shreenandansonu/alphion_potentiostat/readme.md

# ALPHION POTENTIOSTAT
<p align ="center">
    <a href="https://alphaion.io/">
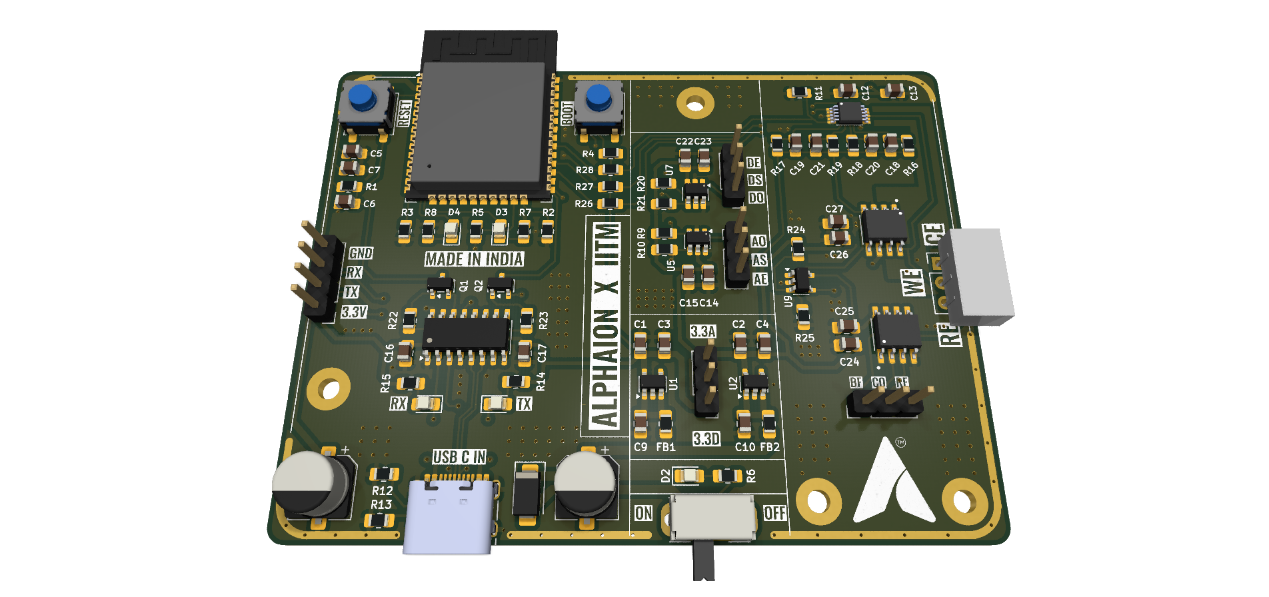
[picture p1: IMAGES/Potentiostat.png]
        
    </a>
</p>

## Overview

This Project is a basemodel for the ALPHION POTENTIOSTAT. Which is based on the research done at IITM by Bikash Kumar Mishra
