shreenandansonu/alphion_potentiostat/PCB DESIGN/Components/LMP7721MAX_NOPB/LMP7721MAX_NOPB.STEP

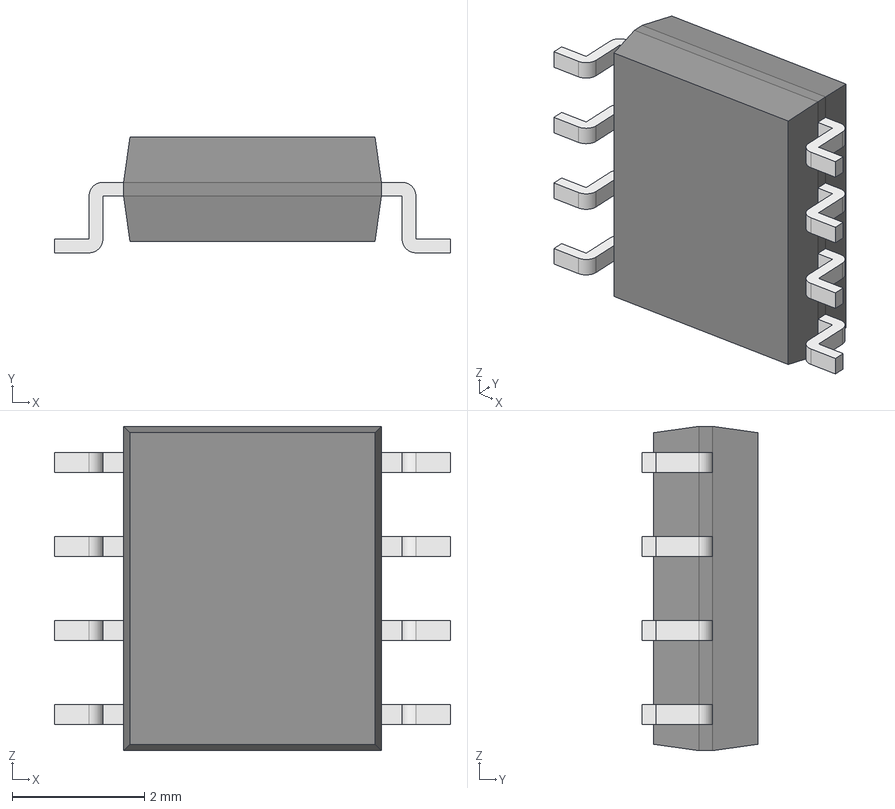
[picture p15: CAD file, 2026-10-17]
PCB DESIGN/Components/LMP7721MAX_NOPB/LMP7721MAX_NOPB.STEP
5.99 x 1.75 x 4.91 mm
Body001 (Mirror #1) x 4
XY-plane x 12
X-axis x 12
