shreenandansonu/alphion_potentiostat/PCB DESIGN/Components/OPA2320AIDGKR/OPA2320AIDGKR.step

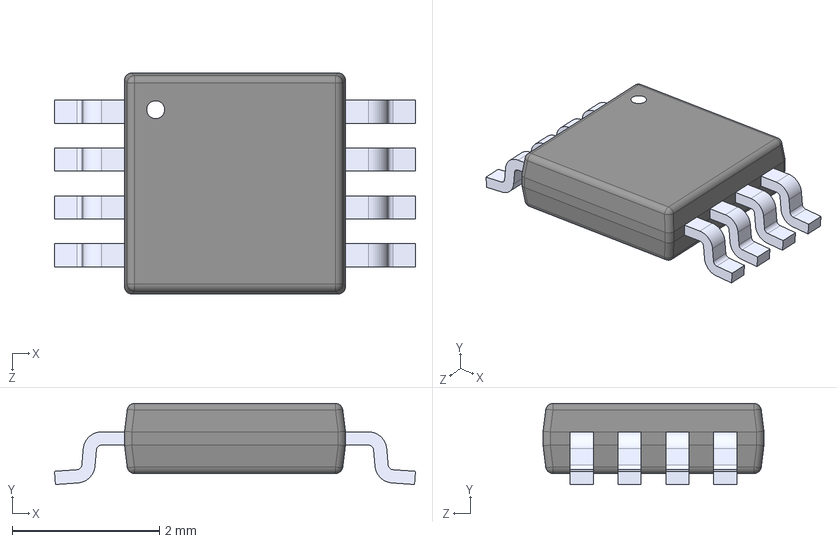
[picture p16: CAD file, 2026-10-17]
PCB DESIGN/Components/OPA2320AIDGKR/OPA2320AIDGKR.step
4.90 x 1.10 x 3.00 mm
