shreenandansonu/alphion_potentiostat/PCB DESIGN/Potentiostat/Electrode.stp

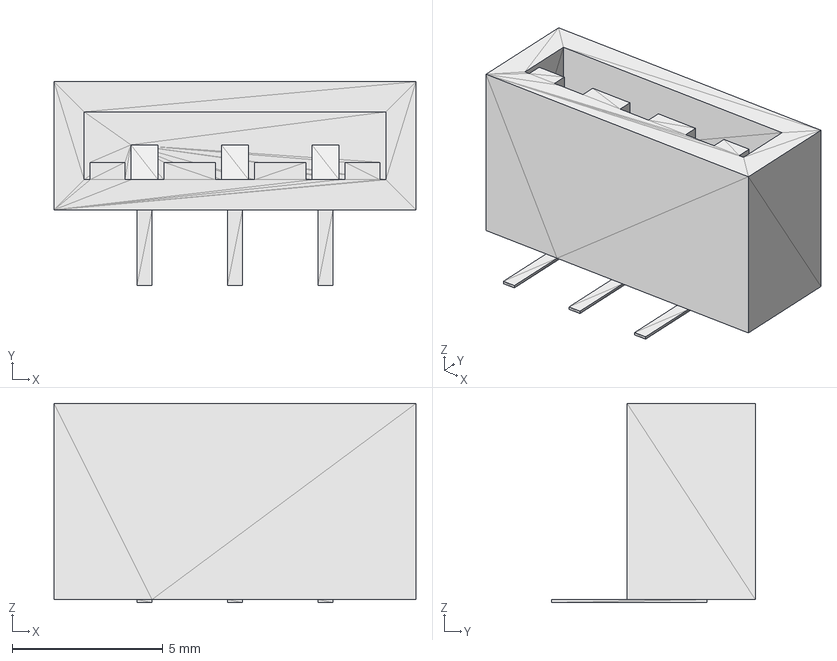
[picture p17: CAD file, 2026-10-17]
PCB DESIGN/Potentiostat/Electrode.stp
12.0 x 6.75 x 6.60 mm
