shreenandansonu/alphion_potentiostat/PCB DESIGN/Potentiostat/TYPE-C-31-M-12--3DModel-STEP-56544.STEP

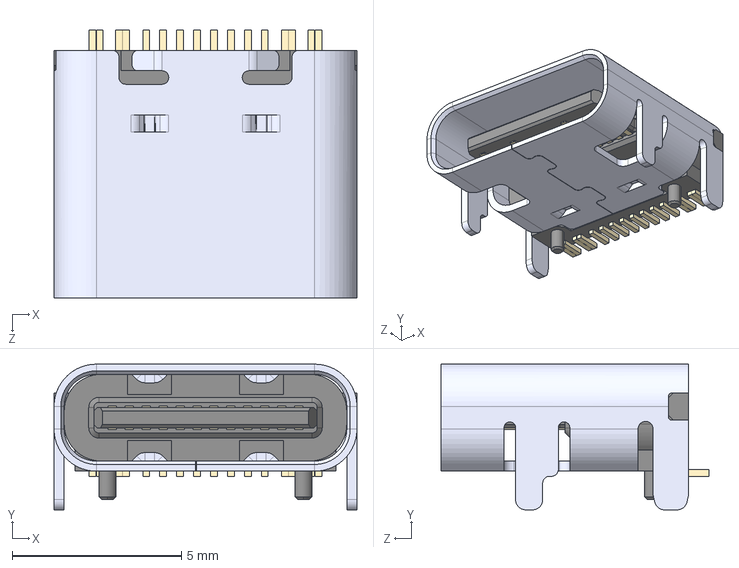
[picture p18: CAD file, 2026-10-17]
PCB DESIGN/Potentiostat/TYPE-C-31-M-12--3DModel-STEP-56544.STEP
8.94 x 4.30 x 7.90 mm
