shreenandansonu/alphion_potentiostat/CODES/MCP4725_TEST/Test Result.png

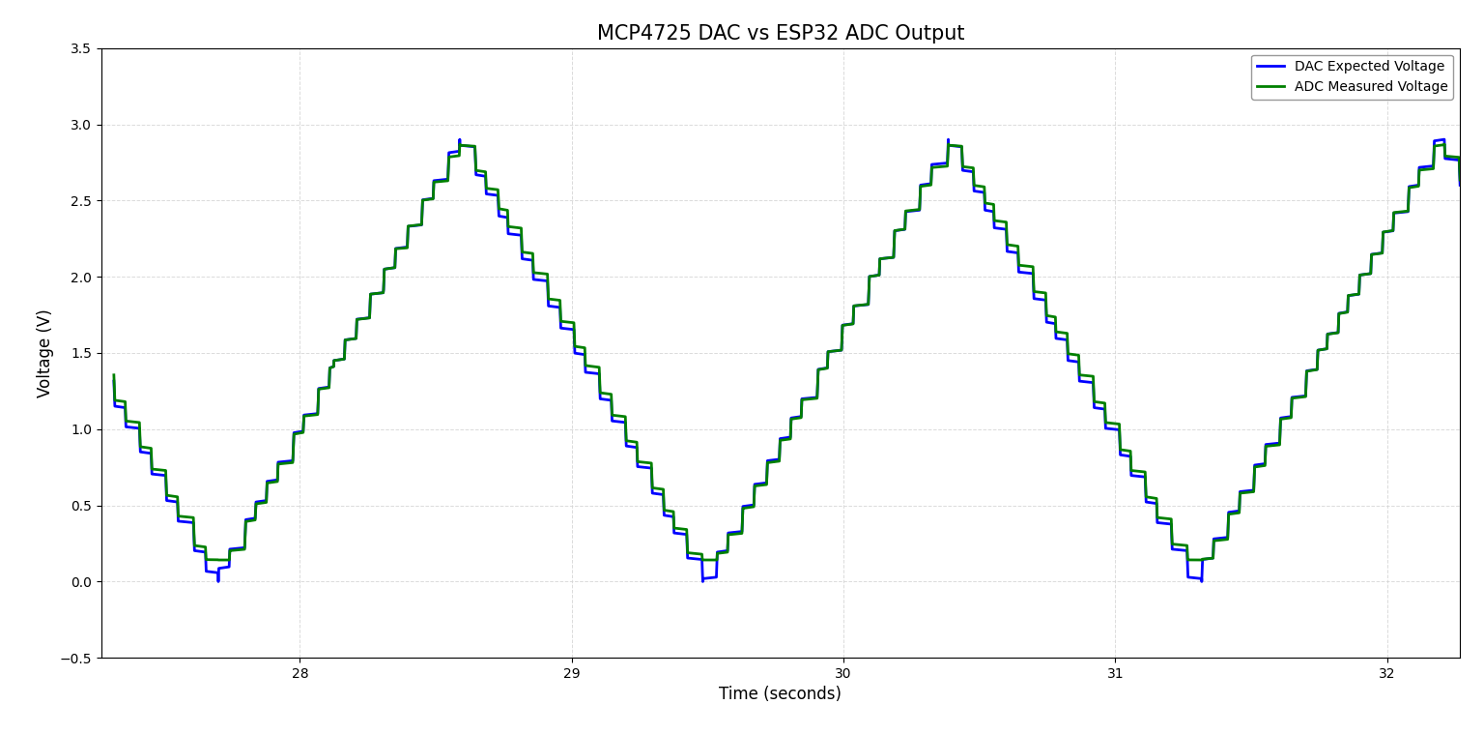
CODES/MCP4725_TEST/Test Result.png
