shreenandansonu/alphion_potentiostat/PCB DESIGN/Potentiostat/Potentiostat.pdf

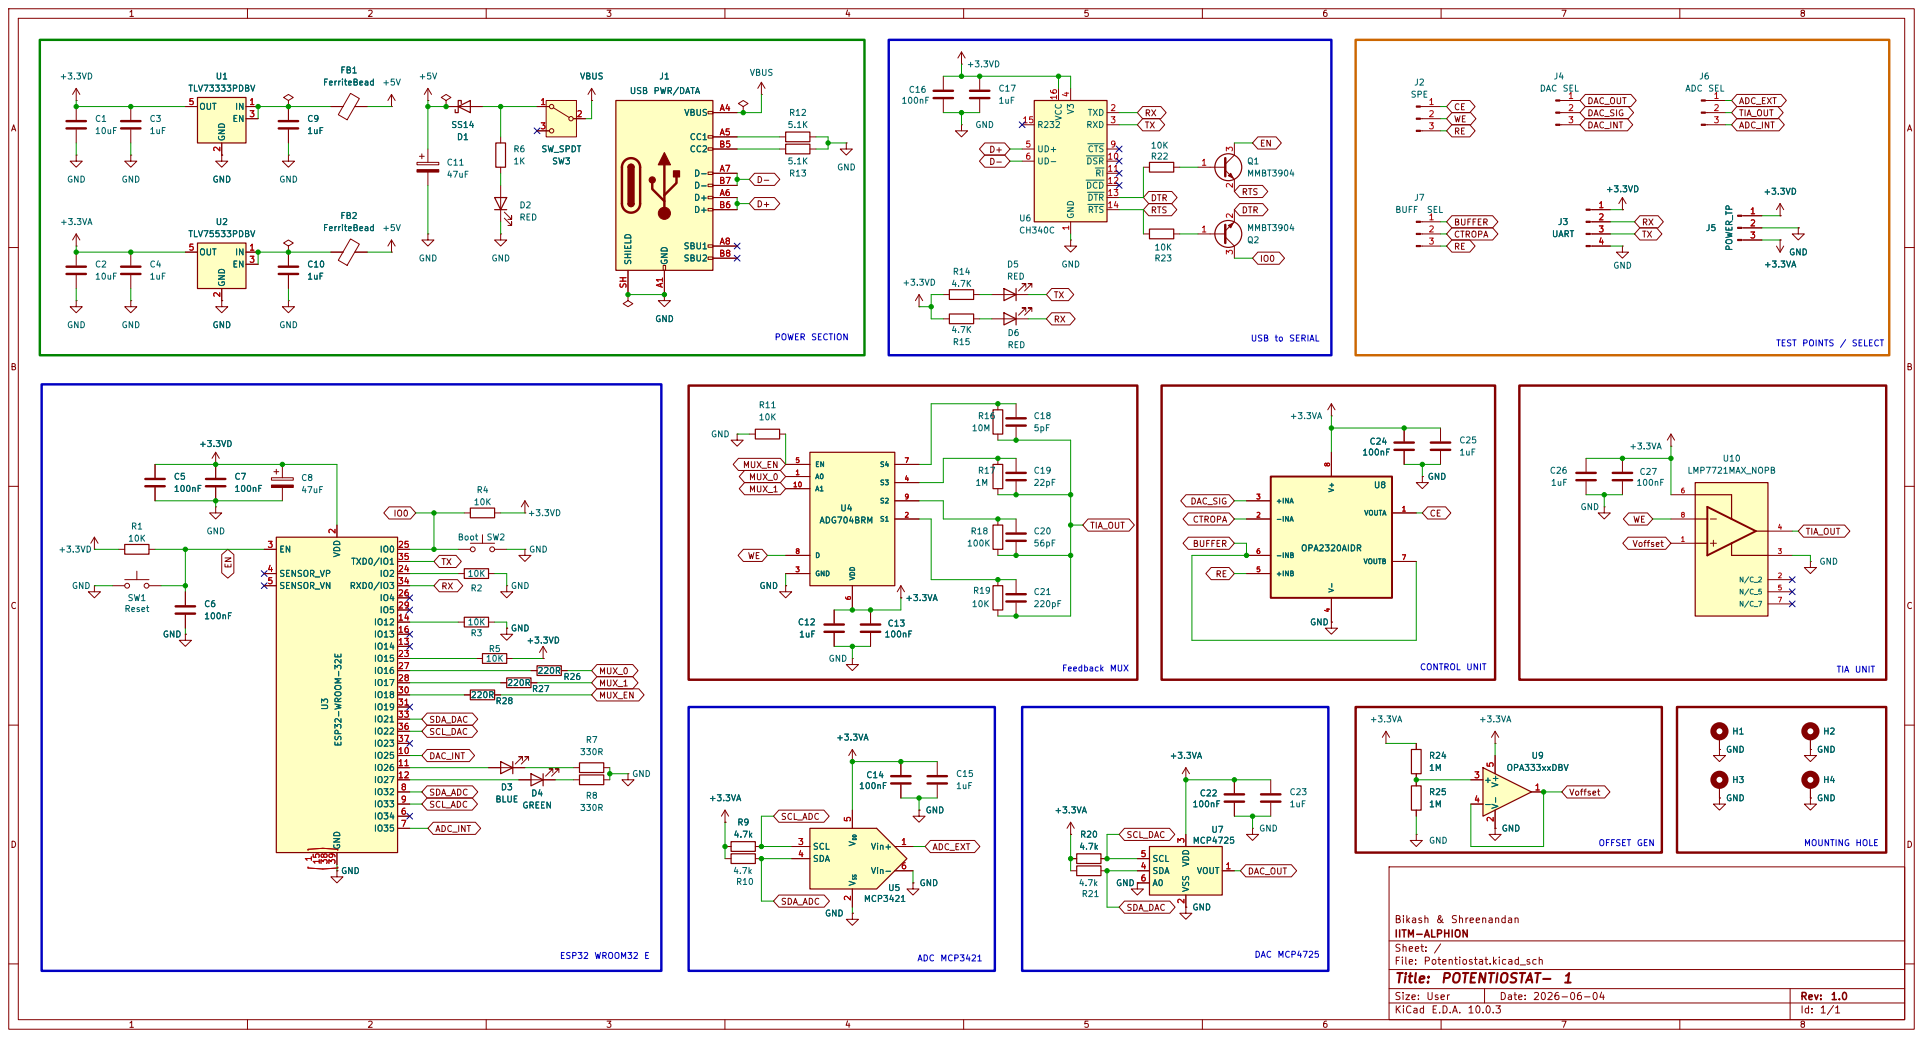
[picture p20: page 1]

VBUS GND A1
J1 USB PWR/DATA GND A1

4 UD+ 5 UD- 6 CTS 9 DSR 10 RI 11 DCD 12 DTR 13 RTS 14 R232 15 VCC 16 U6CH340C

Size: User | Rev: 1.0
KiCad E.D.A. 10.0.3 | Id: 1/1
