shreenandansonu/alphion_potentiostat/PCB DESIGN/Potentiostat/Potentiostat.kicad_pcb

## KiCad design PCB DESIGN/Potentiostat/Potentiostat.kicad_pcb (2026-10-17)

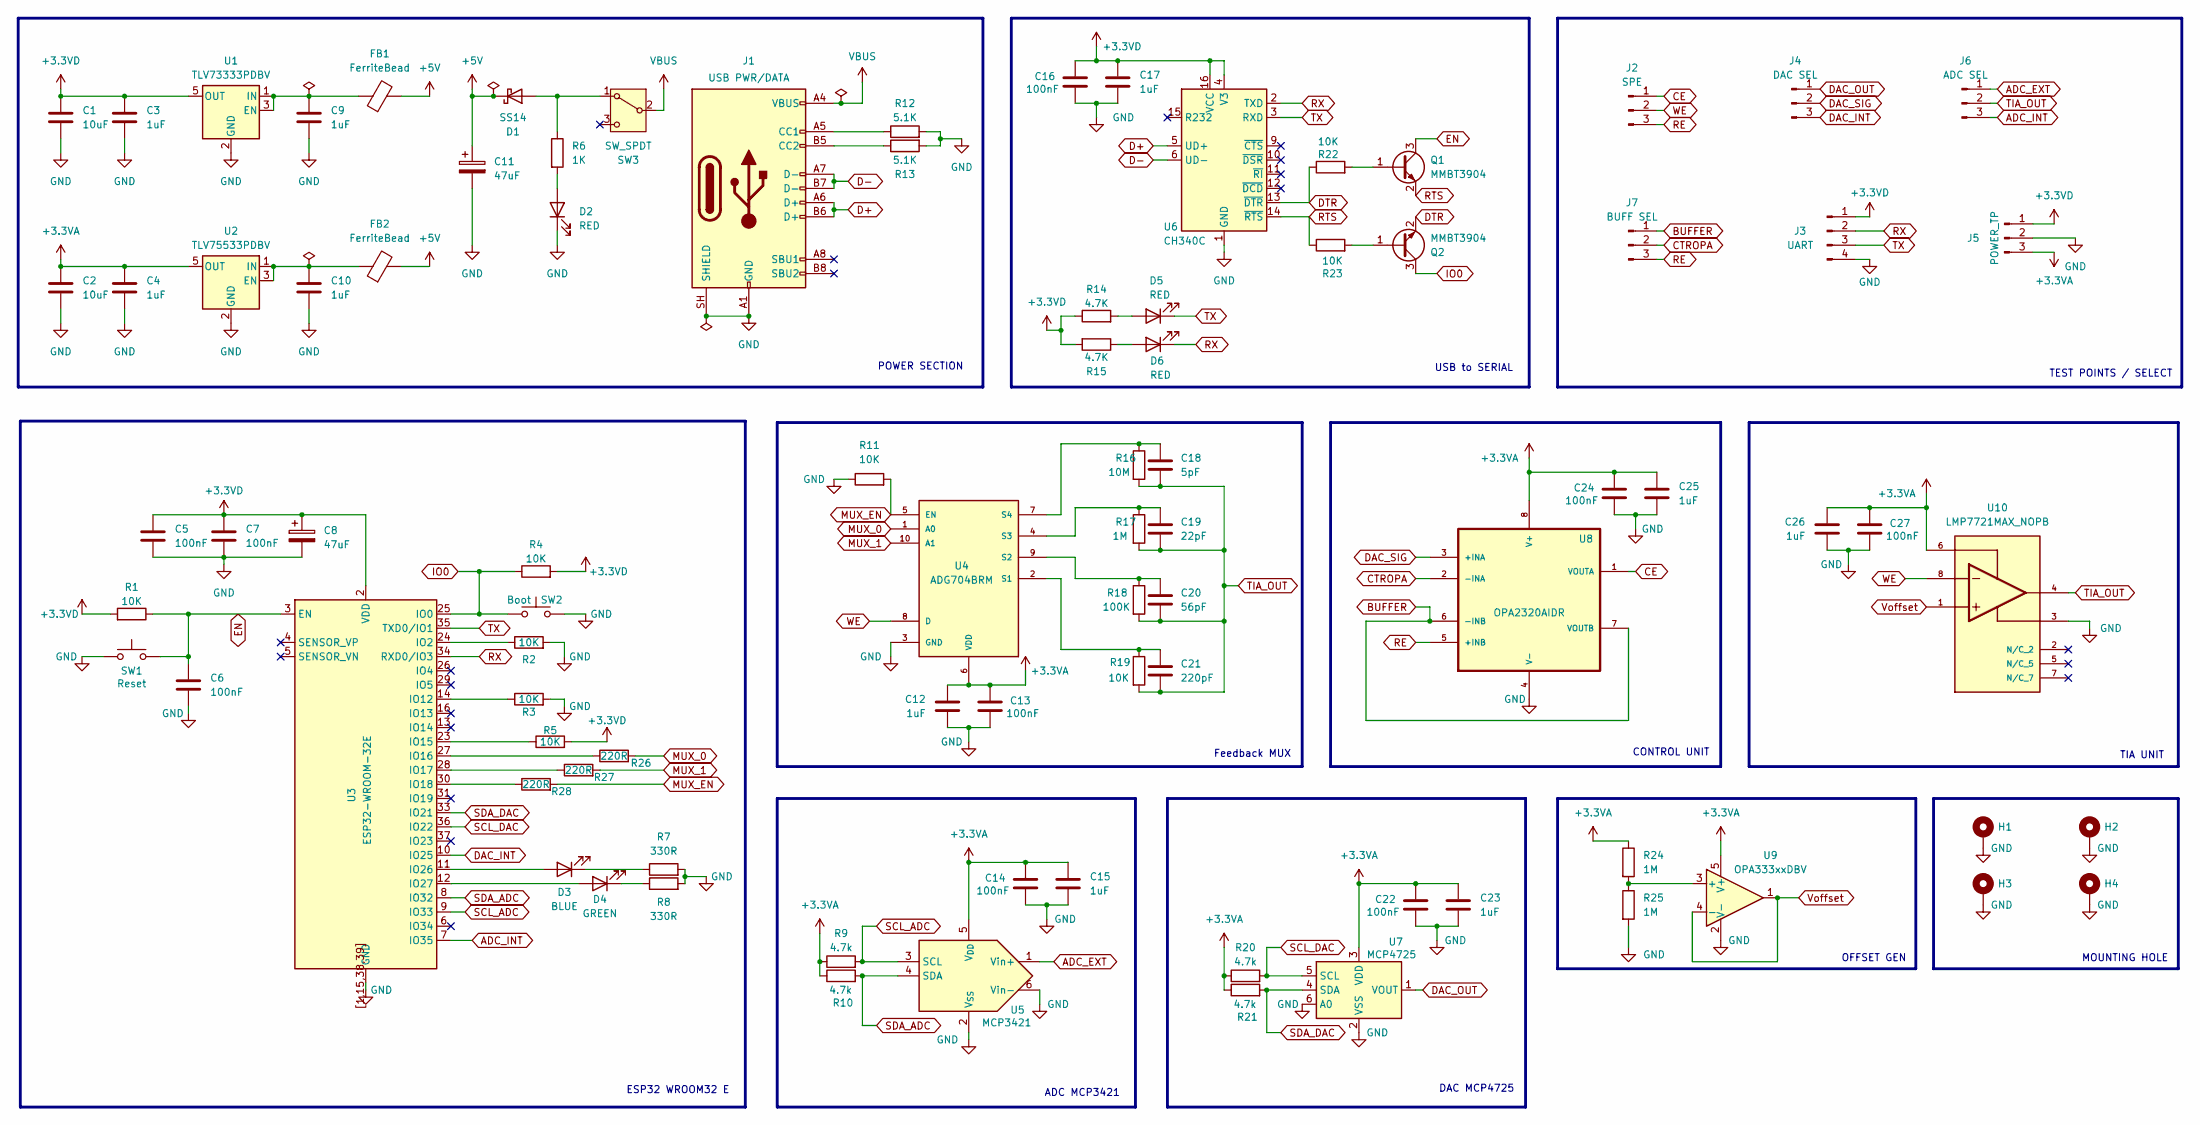
[picture p21: schematic Potentiostat.kicad_sch, POTENTIOSTAT- 1]

Parts:
C1, C2: 10uF; C_0805_2012Metric_Pad1.18x1.45mm_HandSolder
C3, C4, C9, C10, C12, C15, C17, C23, C25, C26: 1uF; C_0805_2012Metric_Pad1.18x1.45mm_HandSolder
C5, C6, C7, C13, C14, C16, C22, C24, C27: 100nF; C_0805_2012Metric_Pad1.18x1.45mm_HandSolder
C8, C11: 47uF; CP_Elec_6.3x5.8
C18: 5pF; C_0805_2012Metric_Pad1.18x1.45mm_HandSolder
C19: 22pF; C_0805_2012Metric_Pad1.18x1.45mm_HandSolder
C20: 56pF; C_0805_2012Metric_Pad1.18x1.45mm_HandSolder
C21: 220pF; C_0805_2012Metric_Pad1.18x1.45mm_HandSolder
D1: SS14; D_SMA
D2, D5, D6: RED; LED_0805_2012Metric_Pad1.15x1.40mm_HandSolder
D3: BLUE; LED_0805_2012Metric_Pad1.15x1.40mm_HandSolder
D4: GREEN; LED_0805_2012Metric_Pad1.15x1.40mm_HandSolder
FB1, FB2: FerriteBead; R_0805_2012Metric_Pad1.20x1.40mm_HandSolder
H1, H2, H3, H4: MountingHole_2.5mm_Pad
J1: USB PWR/DATA; USB_C_Receptacle_HRO_TYPE-C-31-M-12
J2: SPE; PinHeader_1x03_P2.54mm_Vertical
J3: UART; PinHeader_1x04_P2.54mm_Vertical
J4: DAC SEL; PinHeader_1x03_P2.54mm_Vertical
J5: POWER_TP; PinHeader_1x03_P2.54mm_Vertical
J6: ADC SEL; PinHeader_1x03_P2.54mm_Vertical
J7: BUFF SEL; PinHeader_1x03_P2.54mm_Vertical
Q1, Q2: MMBT3904; SOT-23
R1, R2, R3, R4, R5, R11, R19, R22, R23: 10K; R_0805_2012Metric_Pad1.20x1.40mm_HandSolder
R6: 1K; R_0805_2012Metric_Pad1.20x1.40mm_HandSolder
R7, R8: 330R; R_0805_2012Metric_Pad1.20x1.40mm_HandSolder
R9, R10, R20, R21: 4.7k; R_0805_2012Metric_Pad1.20x1.40mm_HandSolder
R12, R13: 5.1K; R_0805_2012Metric_Pad1.20x1.40mm_HandSolder
R14, R15: 4.7K; R_0805_2012Metric_Pad1.20x1.40mm_HandSolder
R16: 10M; R_0805_2012Metric_Pad1.20x1.40mm_HandSolder
R17, R24, R25: 1M; R_0805_2012Metric_Pad1.20x1.40mm_HandSolder
R18: 100K; R_0805_2012Metric_Pad1.20x1.40mm_HandSolder
R26, R27, R28: 220R; R_0805_2012Metric_Pad1.20x1.40mm_HandSolder
SW1: Reset; SW_Push_1P1T_NO_CK_KSC7xxJ
SW2: Boot; SW_Push_1P1T_NO_CK_KSC7xxJ
SW3: SW_SPDT; SW_Slide_SPDT_Angled_CK_OS102011MA1Q
U1: TLV73333PDBV; SOT-23-5
U2: TLV75533PDBV; SOT-23-5
U3: ESP32-WROOM-32E
U4: ADG704BRM; MSOP10
U5: MCP3421; SOT-23-6
U6: CH340C; SOIC-16_3.9x9.9mm_P1.27mm
U7: MCP4725; SOT-23-6_Handsoldering
U8: OPA2320AIDR; SOIC127P599X175-8N
U9: OPA333xxDBV; SOT-23-5
U10: LMP7721MAX_NOPB; SOIC127P599X175-8N; PARTREV E

Connections:
+3.3VA: C2.1, C4.1, C12.1, C13.1, C14.1, C15.1, C22.1, C23.1, C24.1, C25.1, C26.1, C27.1, J5.3, R9.1, R10.1, R20.1, R21.1, R24.1, U2.5 (OUT), U4.6 (VDD), U5.5 (V_{DD}), U7.3 (VDD), U8.8 (V+), U9.5 (V+), U10.6
+3.3VD: C1.1, C3.1, C5.1, C7.1, C8.1, C16.1, C17.1, J3.1, J5.1, R1.2, R4.2, R5.2, R14.1, R15.2, U1.5 (OUT), U3.2 (VDD), U6.4 (V3), U6.16 (VCC)
+5V: C11.1, D1.1 (K), FB1.2, FB2.2
ADC_EXT: J6.1, U5.1 (Vin+)
ADC_INT: J6.3, U3.7 (IO35)
BUFFER: J7.1, U8.6 (-INB), U8.7 (VOUTB)
CE: J2.1, U8.1 (VOUTA)
CTROPA: J7.2, U8.2 (-INA)
D+: J1.A6 (D+), J1.B6 (D+), U6.5 (UD+)
D-: J1.A7 (D-), J1.B7 (D-), U6.6 (UD-)
DAC_INT: J4.3, U3.10 (IO25)
DAC_OUT: J4.1, U7.1 (VOUT)
DAC_SIG: J4.2, U8.3 (+INA)
DTR: Q2.2 (E), R22.1, U6.13 (~DTR)
EN: C6.1, Q1.3 (C), R1.1, SW1.1, U3.3 (EN)
GND: C1.2, C2.2, C3.2, C4.2, C5.2, C6.2, C7.2, C8.2, C9.2, C10.2, C11.2, C12.2, C13.2, C14.2, C15.2, C16.2, C17.2, C22.2, C23.2, C24.2, C25.2, C26.2, C27.2, D2.1 (K), H1.1 (1_1), H2.1 (1_1), H3.1 (1_1), H4.1 (1_1), J1.A1 (GND), J1.A12 (GND), J1.B1 (GND), J1.B12 (GND), J1.SH (SHIELD), J3.4, J5.2, R2.2, R3.2, R7.2, R8.2, R11.1, R12.2, R13.2, R25.2, SW1.2, SW2.1, U1.2 (GND), U2.2 (GND), U3.1 (GND), U3.15 (GND), U3.38 (GND), U3.39 (GND), U3.[1,15,38,39] (GND), U4.3 (GND), U5.2 (V_{SS}), U5.6 (Vin-), U6.1 (GND), U7.2 (VSS), U7.6 (A0), U8.4 (V-), U9.2 (V-), U10.3
IO0: Q2.3 (C), R4.1, SW2.2, U3.25 (IO0)
MUX_0: R26.2, U4.1 (A0)
MUX_1: R27.2, U4.10 (A1)
MUX_EN: R11.2, R28.2, U4.5 (EN)
unnamed: D1.2 (A), R6.1, SW3.1 (A)
unnamed: D2.2 (A), R6.2
unnamed: D3.2 (A), U3.11 (IO26)
unnamed: D3.1 (K), R7.1
unnamed: D4.2 (A), U3.12 (IO27)
unnamed: D4.1 (K), R8.1
unnamed: D5.2 (A), R14.2
unnamed: D6.2 (A), R15.1
unnamed: J1.A5 (CC1), R12.1
unnamed: J1.B5 (CC2), R13.1
unnamed: Q1.1 (B), R22.2
unnamed: Q2.1 (B), R23.2
unnamed: C9.1, FB1.1, U1.1 (IN), U1.3 (EN)
unnamed: C10.1, FB2.1, U2.1 (IN), U2.3 (EN)
unnamed: R2.1, U3.24 (IO2)
unnamed: R3.1, U3.14 (IO12)
unnamed: R5.1, U3.23 (IO15)
unnamed: R26.1, U3.27 (IO16)
unnamed: R27.1, U3.28 (IO17)
unnamed: R28.1, U3.30 (IO18)
unnamed: C21.1, R19.1, U4.2 (S1)
unnamed: C20.1, R18.1, U4.9 (S2)
unnamed: C19.1, R17.1, U4.4 (S3)
unnamed: C18.1, R16.1, U4.7 (S4)
unnamed: R24.2, R25.1, U9.3 (+)
RE: J2.3, J7.3, U8.5 (+INB)
RTS: Q1.2 (E), R23.1, U6.14 (~RTS)
RX: D6.1 (K), J3.2, U3.34 (RXD0/IO3), U6.2 (TXD)
SCL_ADC: R9.2, U3.9 (IO33), U5.3 (SCL)
SCL_DAC: R20.2, U3.36 (IO22), U7.5 (SCL)
SDA_ADC: R10.2, U3.8 (IO32), U5.4 (SDA)
SDA_DAC: R21.2, U3.33 (IO21), U7.4 (SDA)
TIA_OUT: C18.2, C19.2, C20.2, C21.2, J6.2, R16.2, R17.2, R18.2, R19.2, U10.4
TX: D5.1 (K), J3.3, U3.35 (TXD0/IO1), U6.3 (RXD)
VBUS: J1.A4 (VBUS), J1.A9 (VBUS), J1.B4 (VBUS), J1.B9 (VBUS), SW3.2 (B)
Voffset: U9.1, U9.4 (-), U10.1
WE: J2.2, U4.8 (D), U10.8

Notes on the sheet:
TIA UNIT
CONTROL UNIT
TEST POINTS / SELECT
ESP32 WROOM32 E
MOUNTING HOLE
ADC MCP3421
Feedback MUX
DAC MCP4725
OFFSET GEN
POWER SECTION
USB to SERIAL

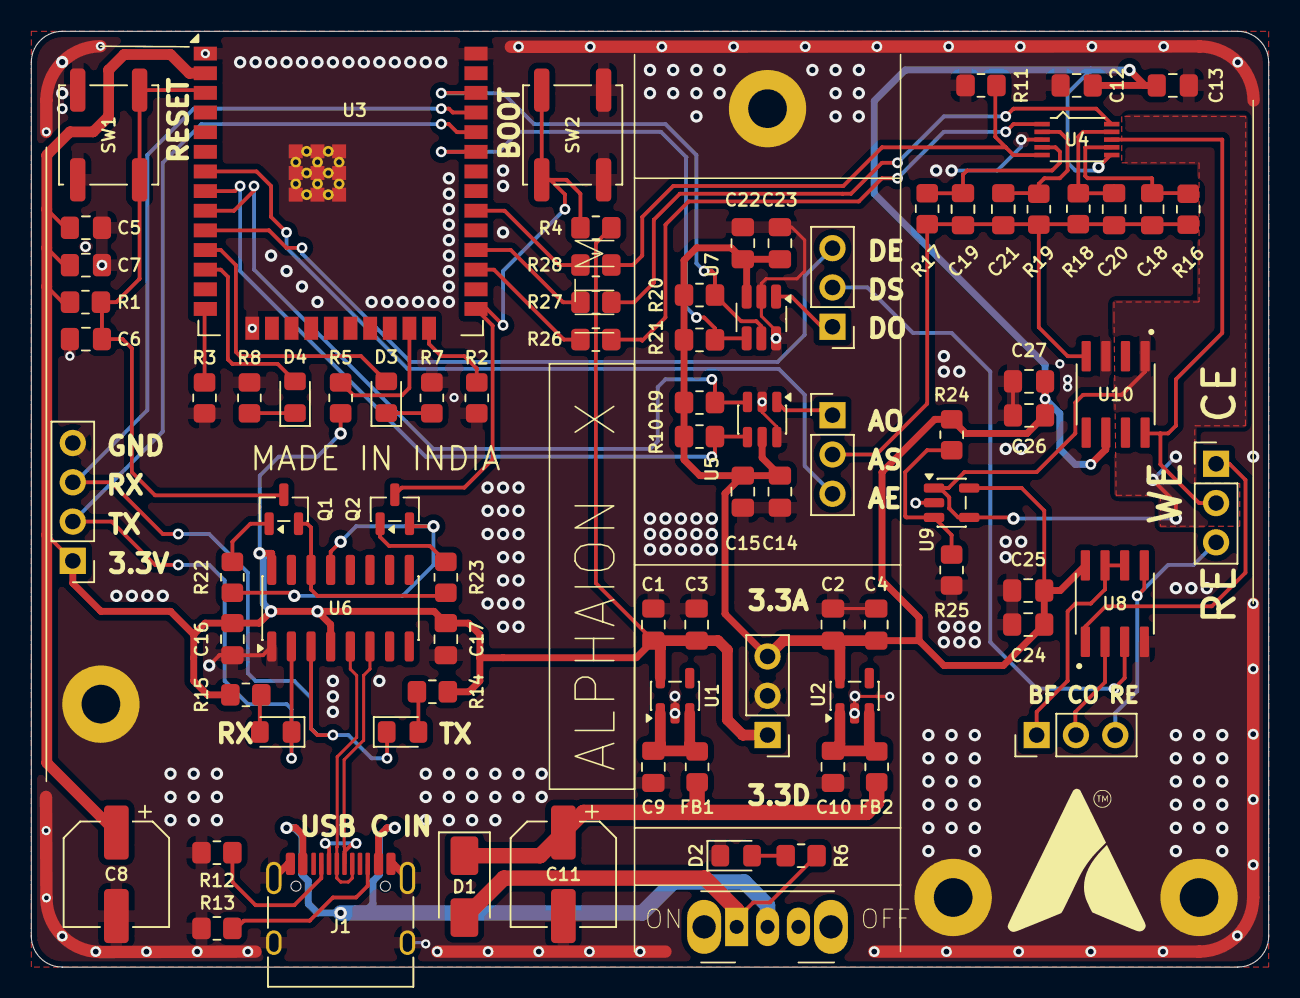
[picture p22: board Potentiostat.kicad_pcb from above]

Board: 2 copper layers, 80.0 x 60.5 mm, 89 parts (0 on the bottom side), 57 nets.
